ShauryPatel/Control-Systems-Project/(list of files, cad)

Other CAD files:
CAD files/Ball Slider.f3d
CAD files/Component12.f3d
CAD files/Joint 1.f3d
CAD files/Joint 2.f3d
CAD files/Lock slider and main base.f3d
CAD files/Supports.f3d
CAD files/WhatsApp base.f3d
