ShauryPatel/Control-Systems-Project/CAD Drawings/Joint 2.pdf

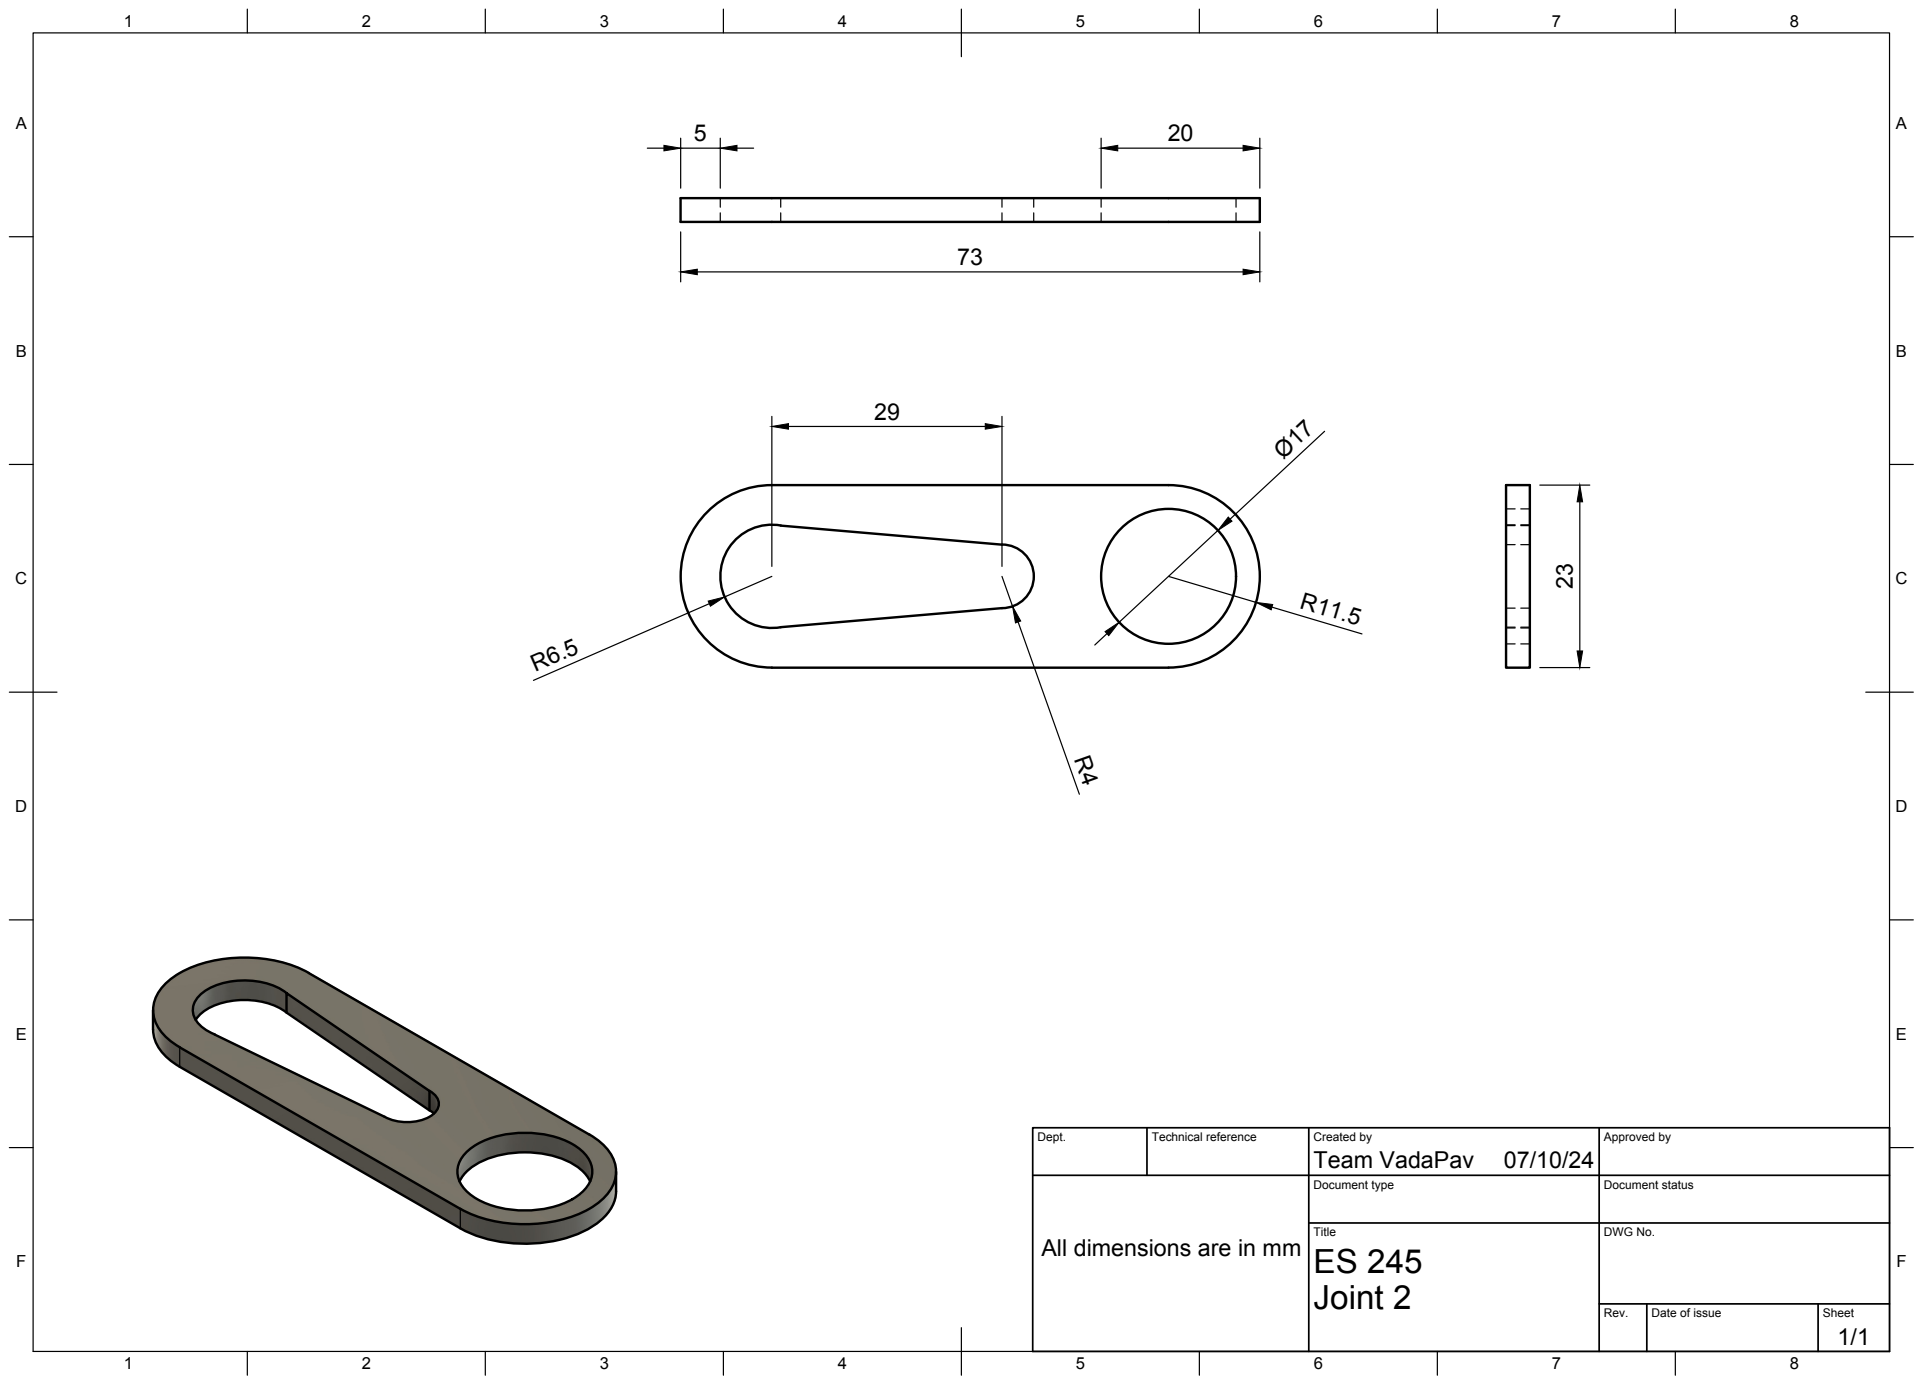
[picture p12: page 1]
Title; DWG No.; Rev.; Date of issue; Sheet; Joint 2

Dept. | Technical reference | Created by Team VadaPav 07/10/24 | Approved by

Document type | Document status

All dimensions are in mm
