ShauryPatel/Control-Systems-Project/CAD Drawings/Main Base.pdf

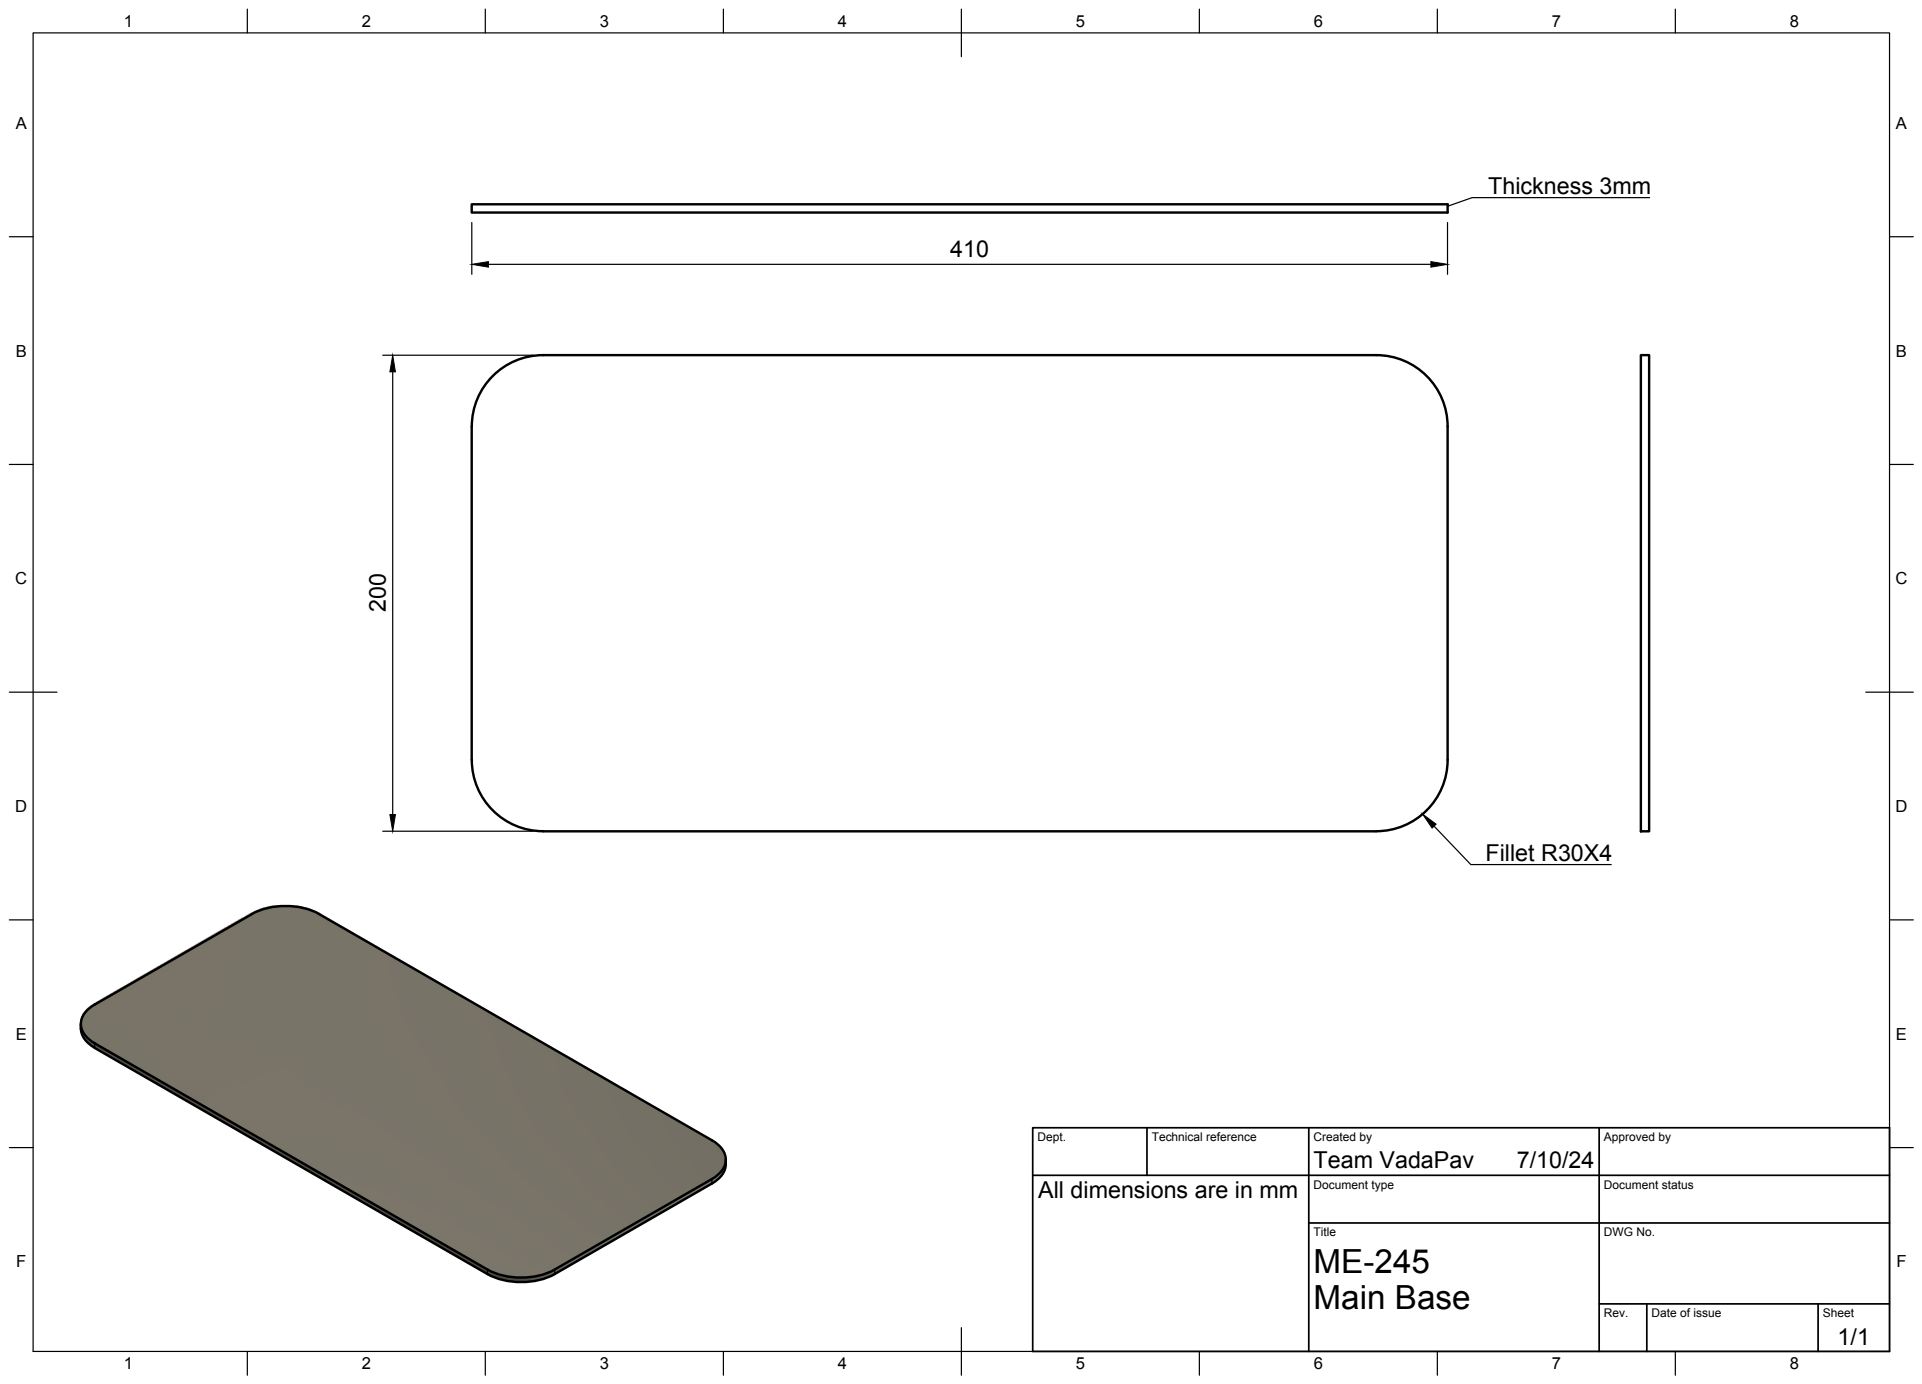
[picture p13: page 1]
Title; DWG No.; Rev.; Date of issue; Sheet; Main Base; Team VadaPav 200; Thickness 3mm; Fillet R30X4

Dept. | Technical reference | Created by 7/10/24 | Approved by

All dimensions are in mm

Document type | Document status
