ShauryPatel/Control-Systems-Project/CAD Drawings/Ball Slider.pdf

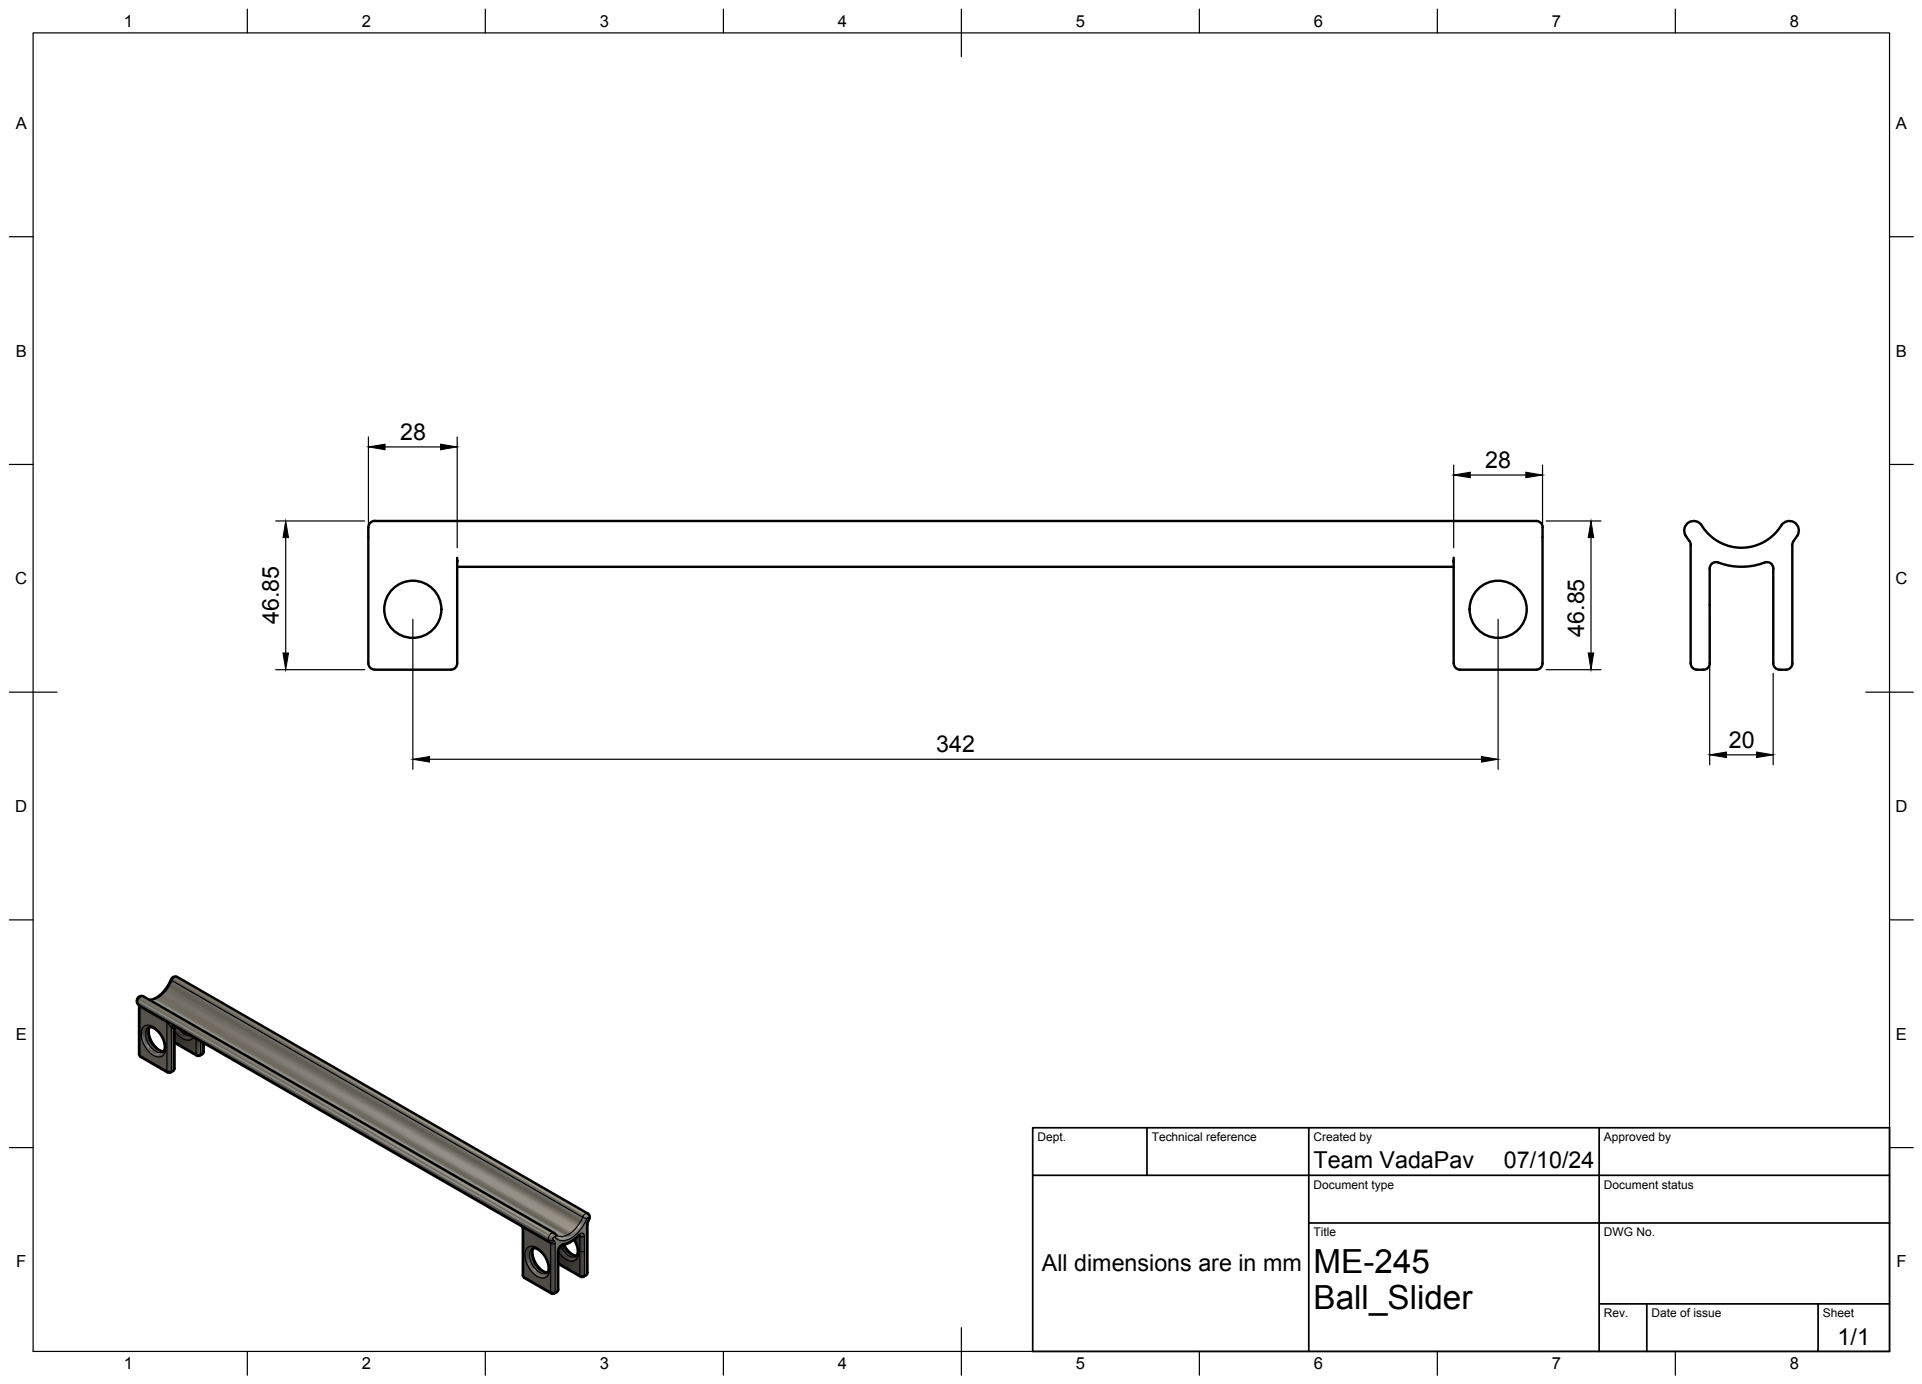
[picture p14: page 1]
Title; DWG No.; Rev.; Date of issue; Sheet

Dept. | Technical reference | Created by Team VadaPav 07/10/24 | Approved by

Document type | Document status

All dimensions are in mm
