ShauryPatel/Control-Systems-Project/CAD Drawings/Joint 1.pdf

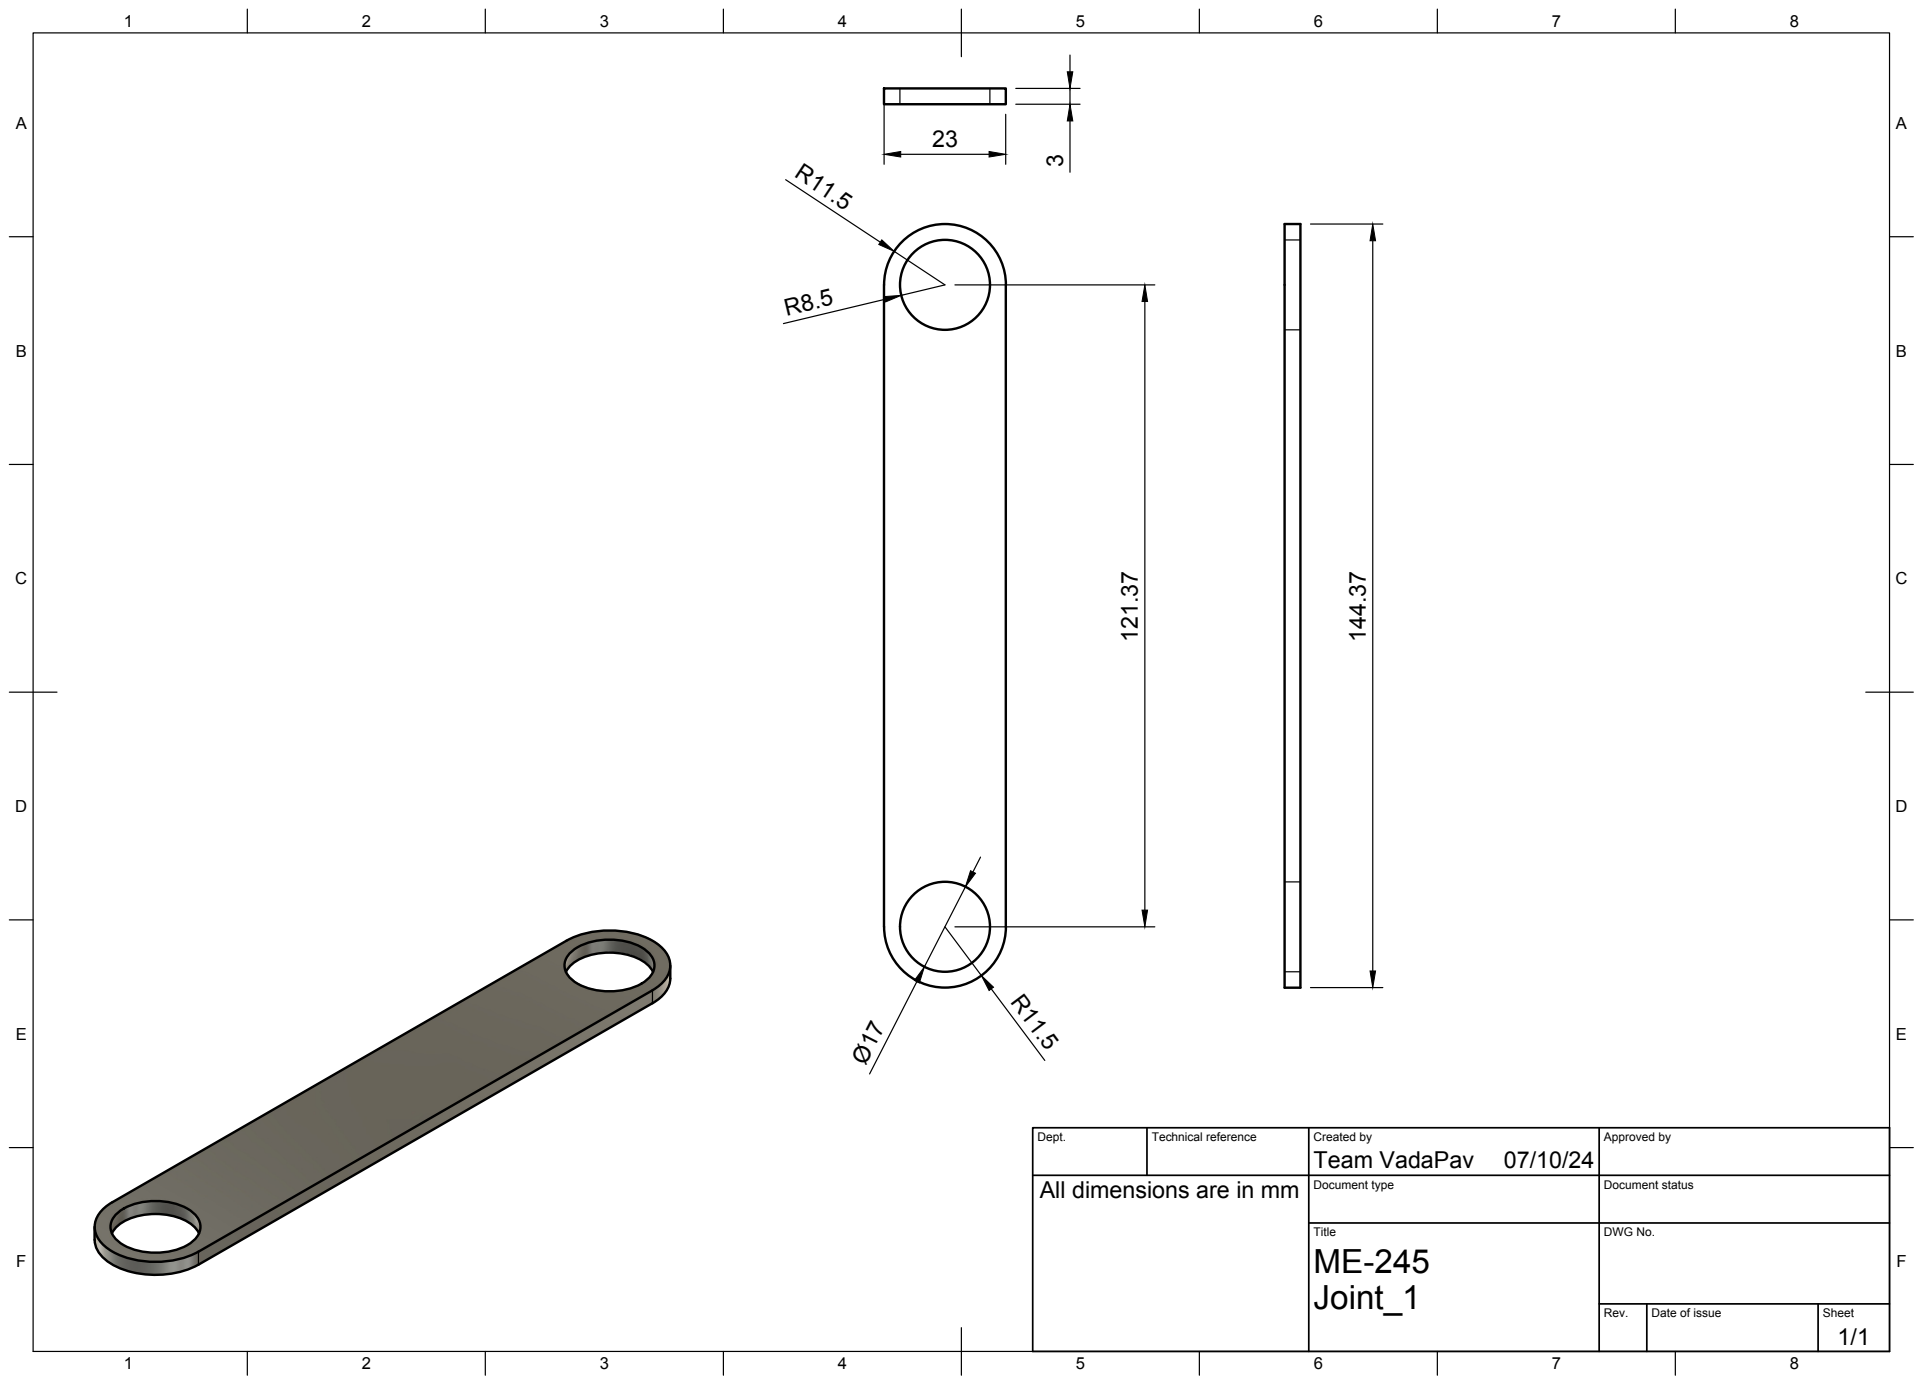
[picture p15: page 1]
Title; DWG No.; Rev.; Date of issue; Sheet; Team VadaPav 121.37

Dept. | Technical reference | Created by 07/10/24 | Approved by

All dimensions are in mm

Document type | Document status
