ShauryPatel/Control-Systems-Project/CAD Drawings/Main structure.pdf

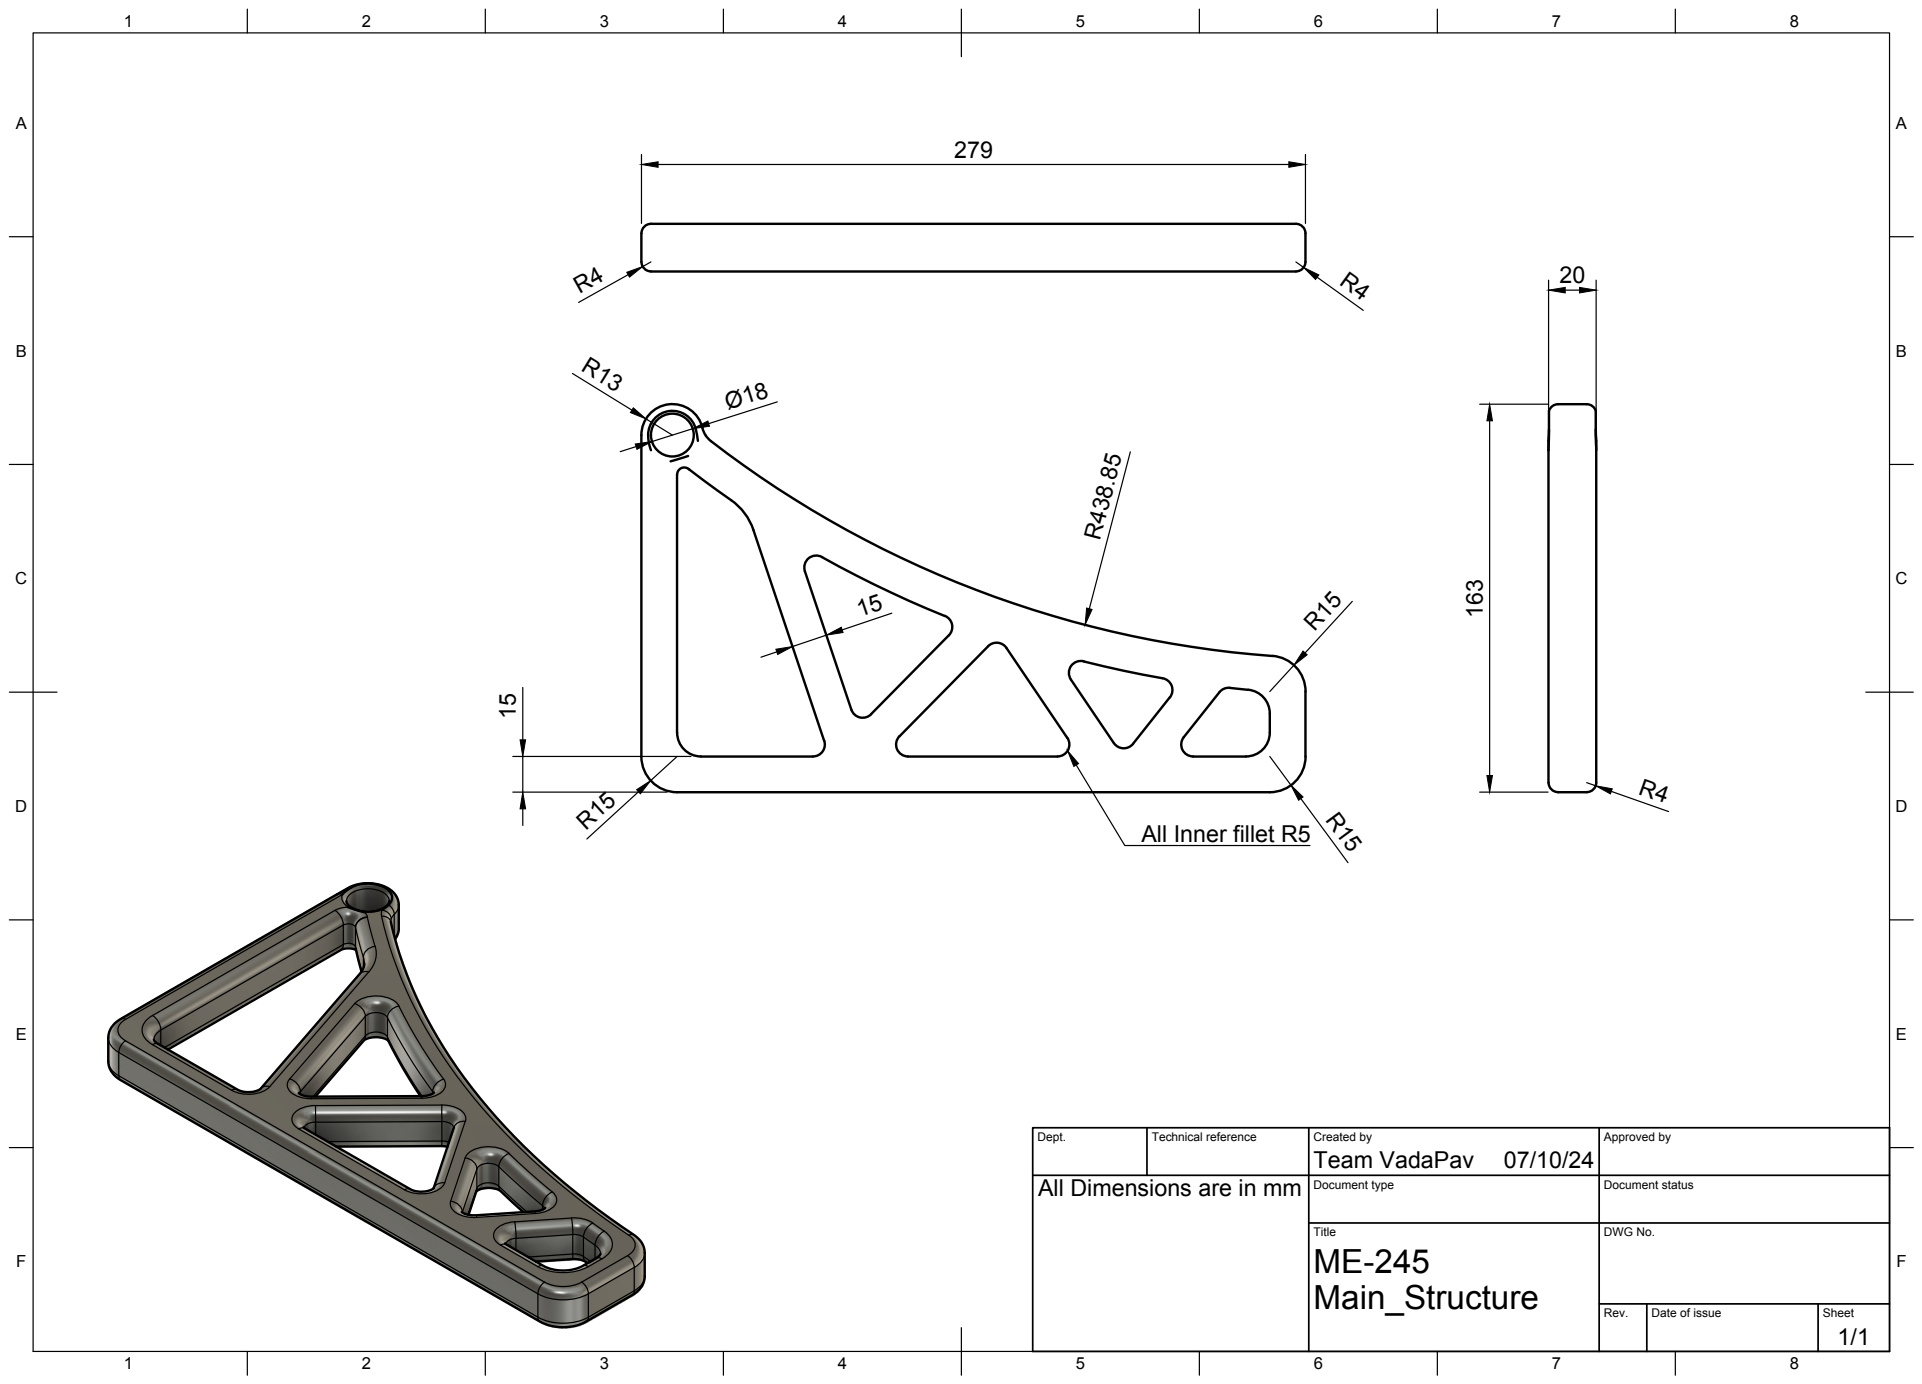
[picture p16: page 1]
Title; DWG No.; Rev.; Date of issue; Sheet

All Inner fillet R5 R1515

Dept. | Technical reference | Created by Team VadaPav 07/10/24 | Approved by

All Dimensions are in mm

Document type | Document status
