ShauryPatel/Control-Systems-Project/CAD Drawings/WhatsApp Support.pdf

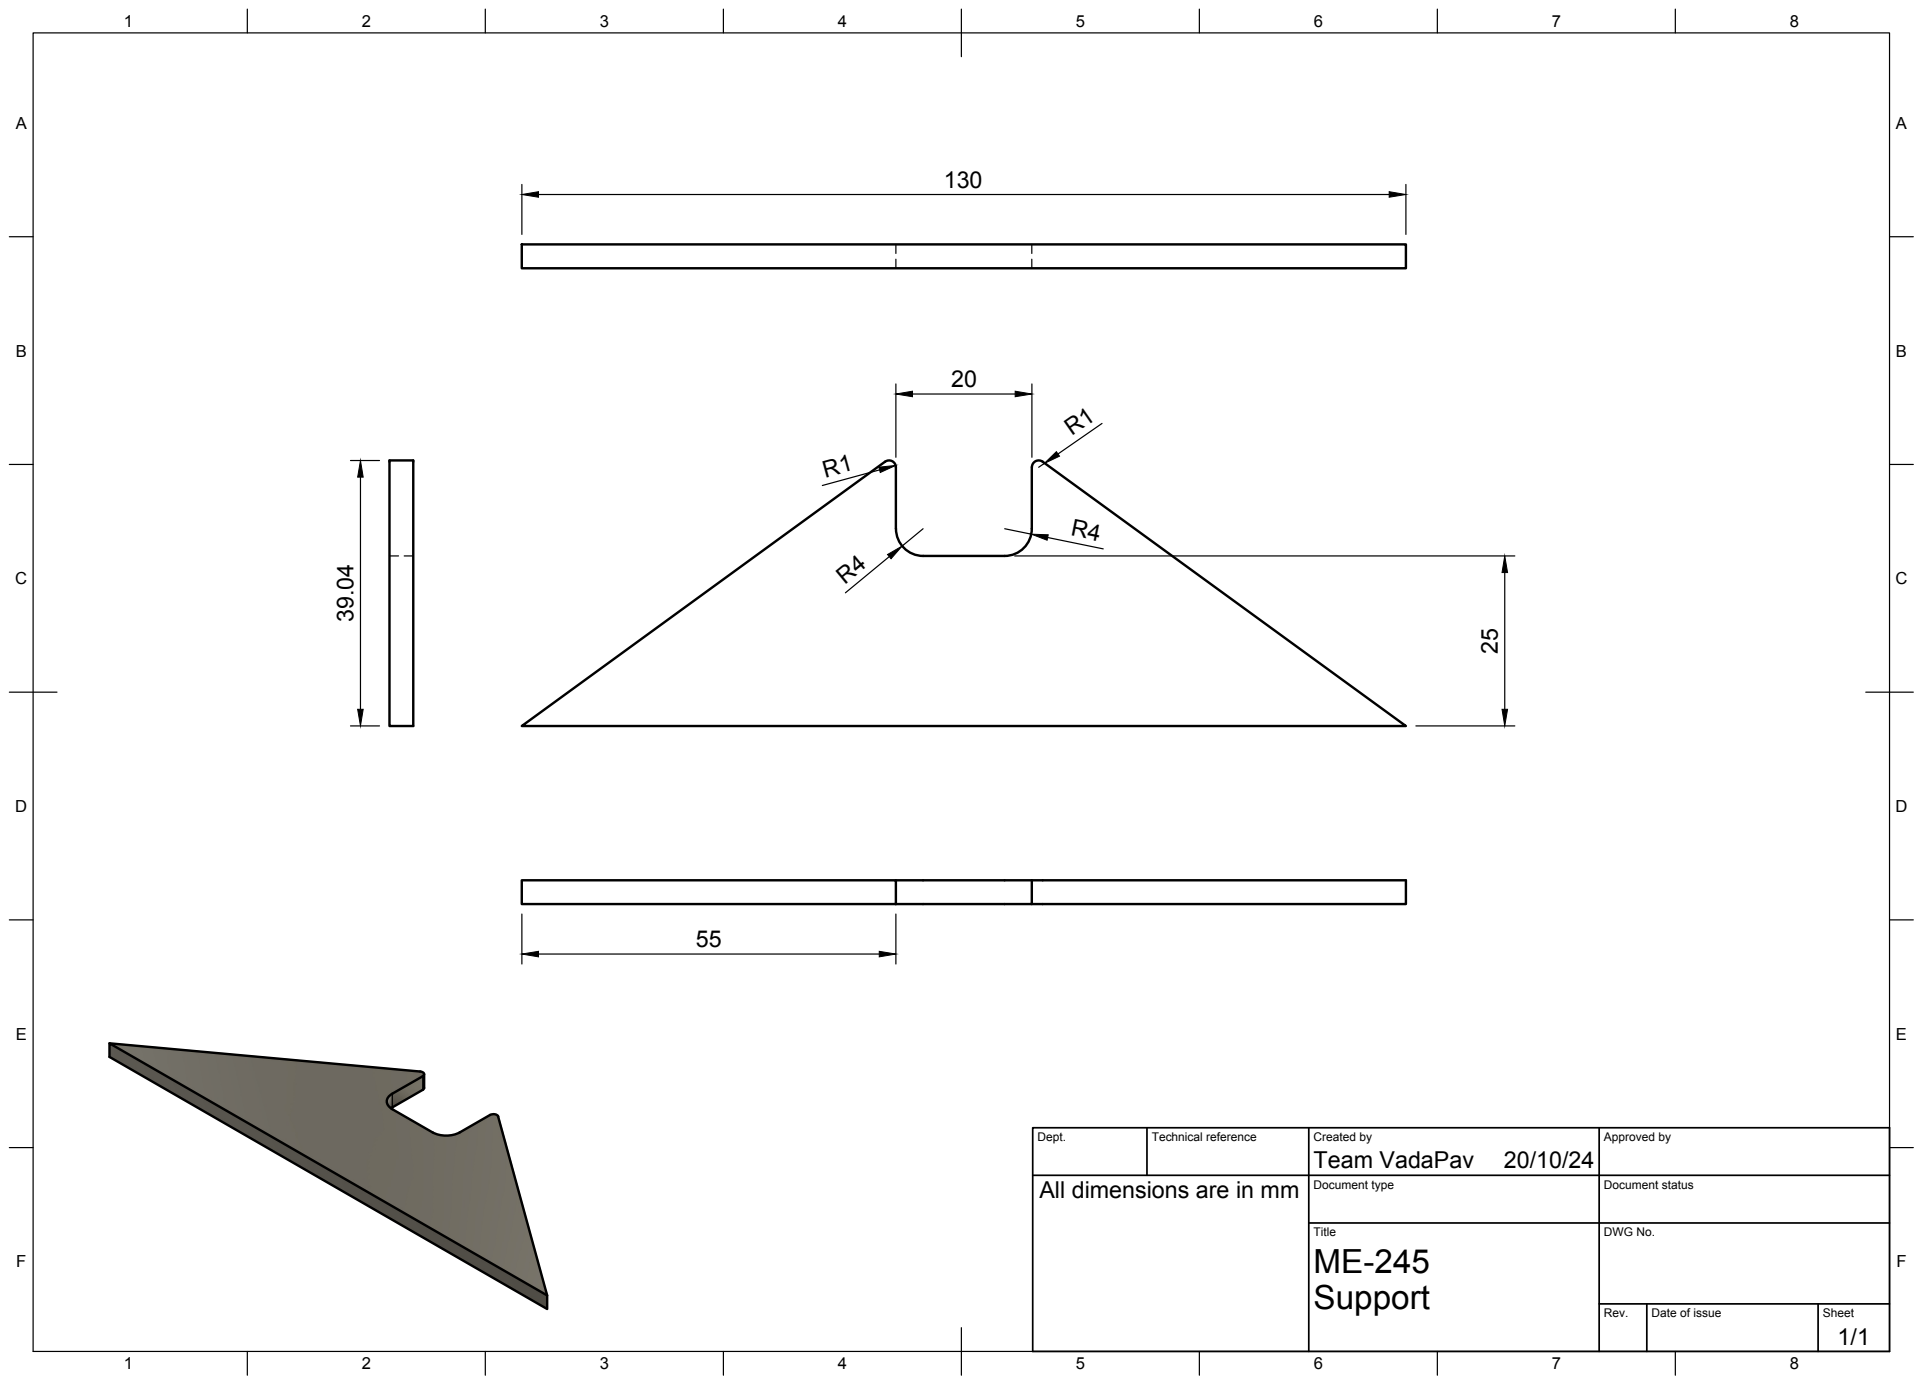
[picture p17: page 1]
Title; DWG No.; Rev.; Date of issue; Sheet; Team VadaPav 39.04

Dept. | Technical reference | Created by 20/10/24 | Approved by

All dimensions are in mm

Document type | Document status
